berkemutluu/Intelligent-Smart-Thermostat/Schemathic_Device1.png

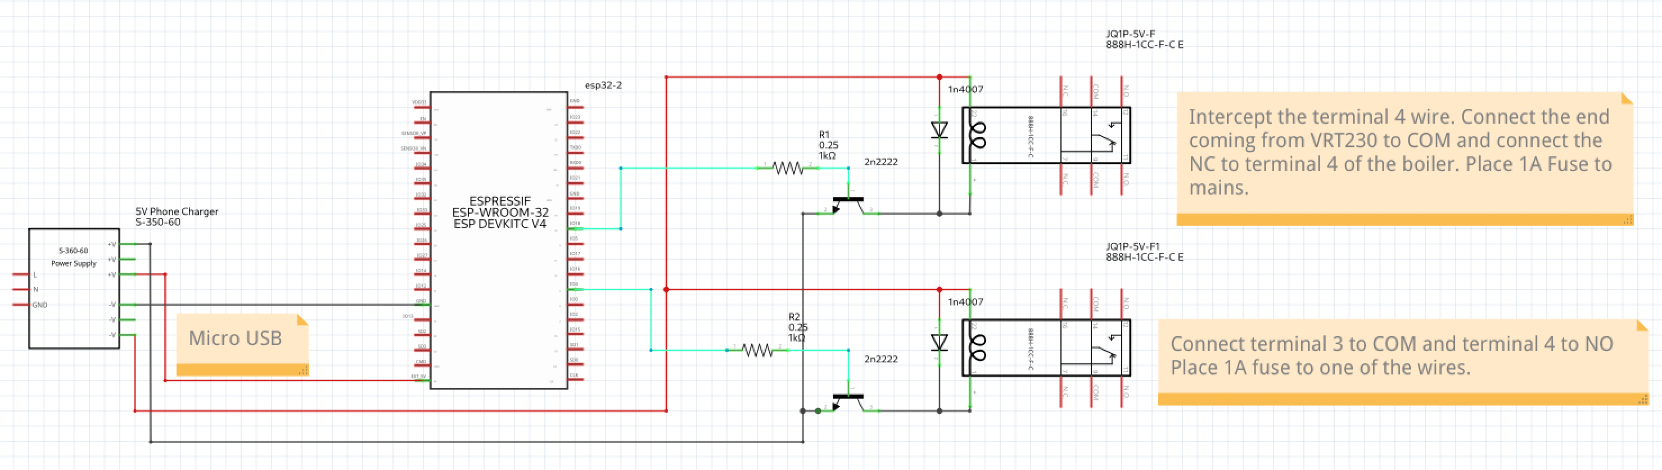
Schemathic_Device1.png
