berkemutluu/Intelligent-Smart-Thermostat/Schemathics_Device_2.png

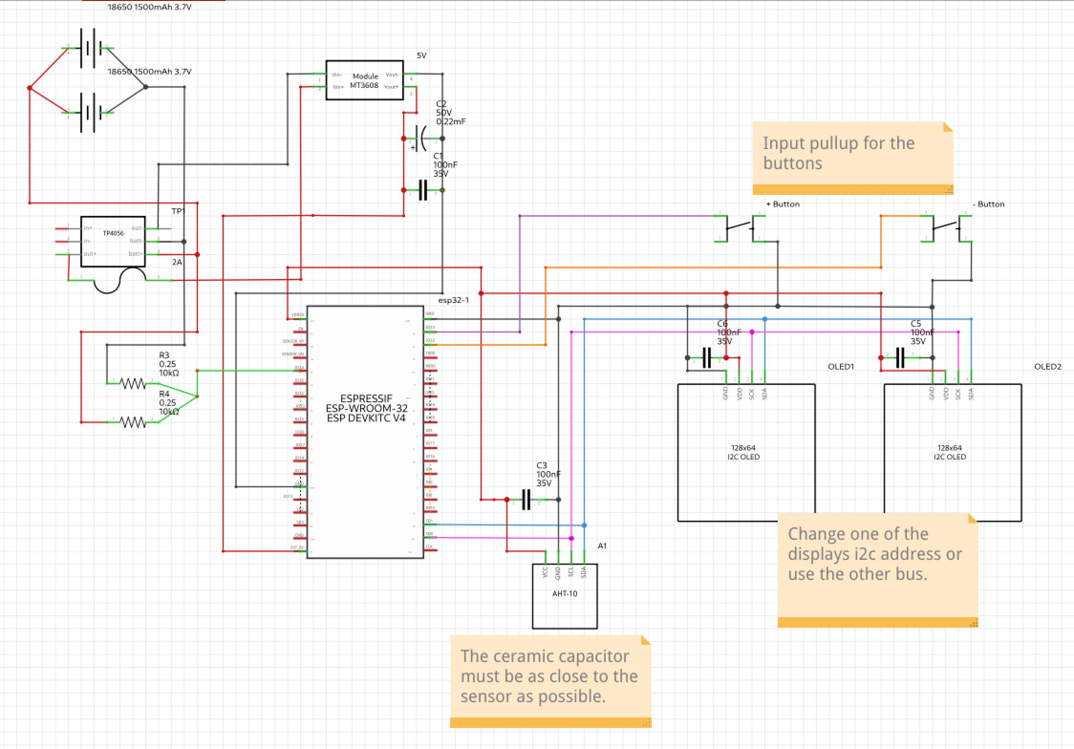
Schemathics_Device_2.png
